eldar6776/Automatic-Lubrication/README.md

# Automatic-Lubrication
Machine Automatic Lubrication Cycle Counter
