eldar6776/Automatic-Lubrication/(list of files, cad)

Other CAD files:
fw/PIC12C508.X/dist/default/production/startup.obj
fw/PIC12C508.X/l.obj
fw/PIC12F675.X/dist/default/production/PIC12F675.X.production.obj
fw/PIC12F675.X/l.obj
fw/PIC12C508.X/dist/default/production/PIC12C508.X.production.obj
fw/PIC12F675.X/dist/default/production/startup.obj
