eldar6776/Automatic-Lubrication/Elektro schematic.pdf

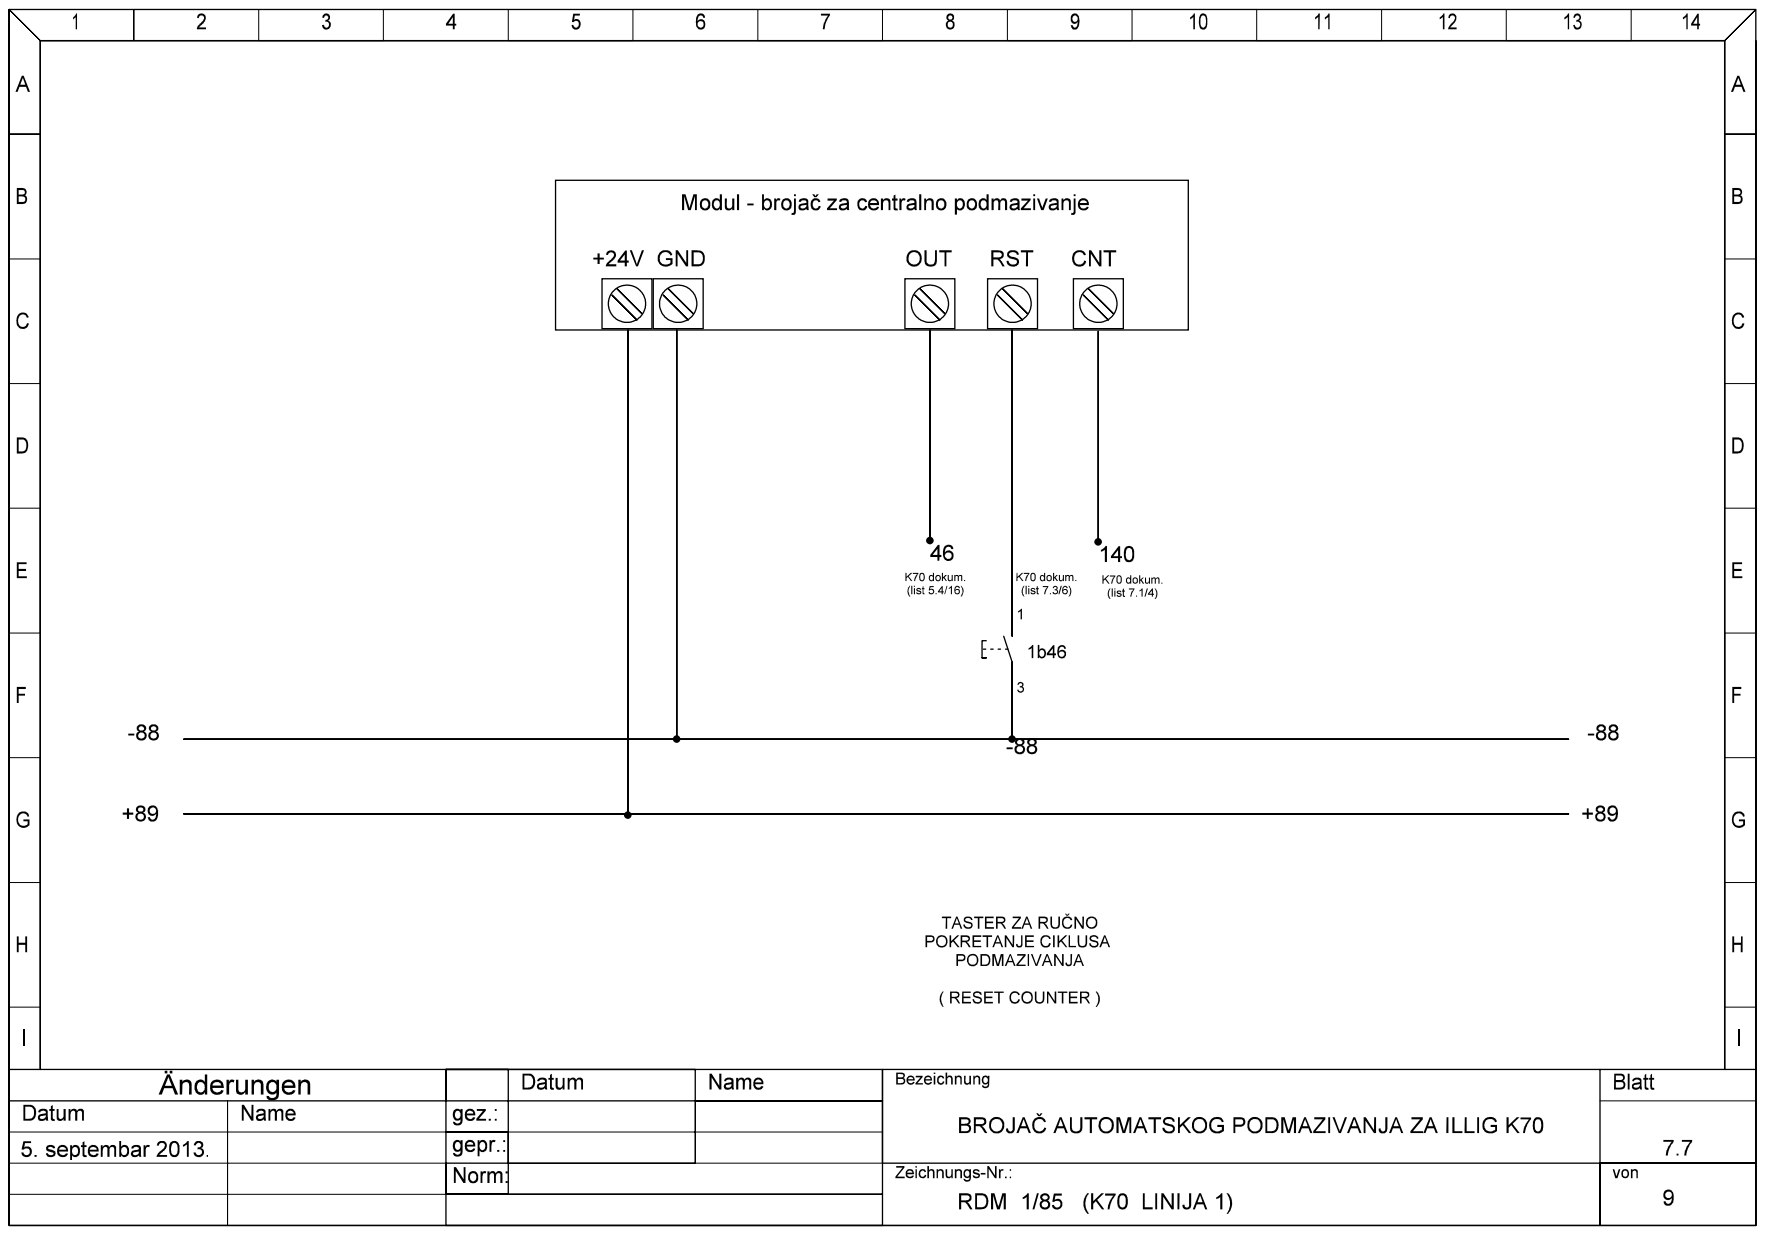
[picture p3: page 1]

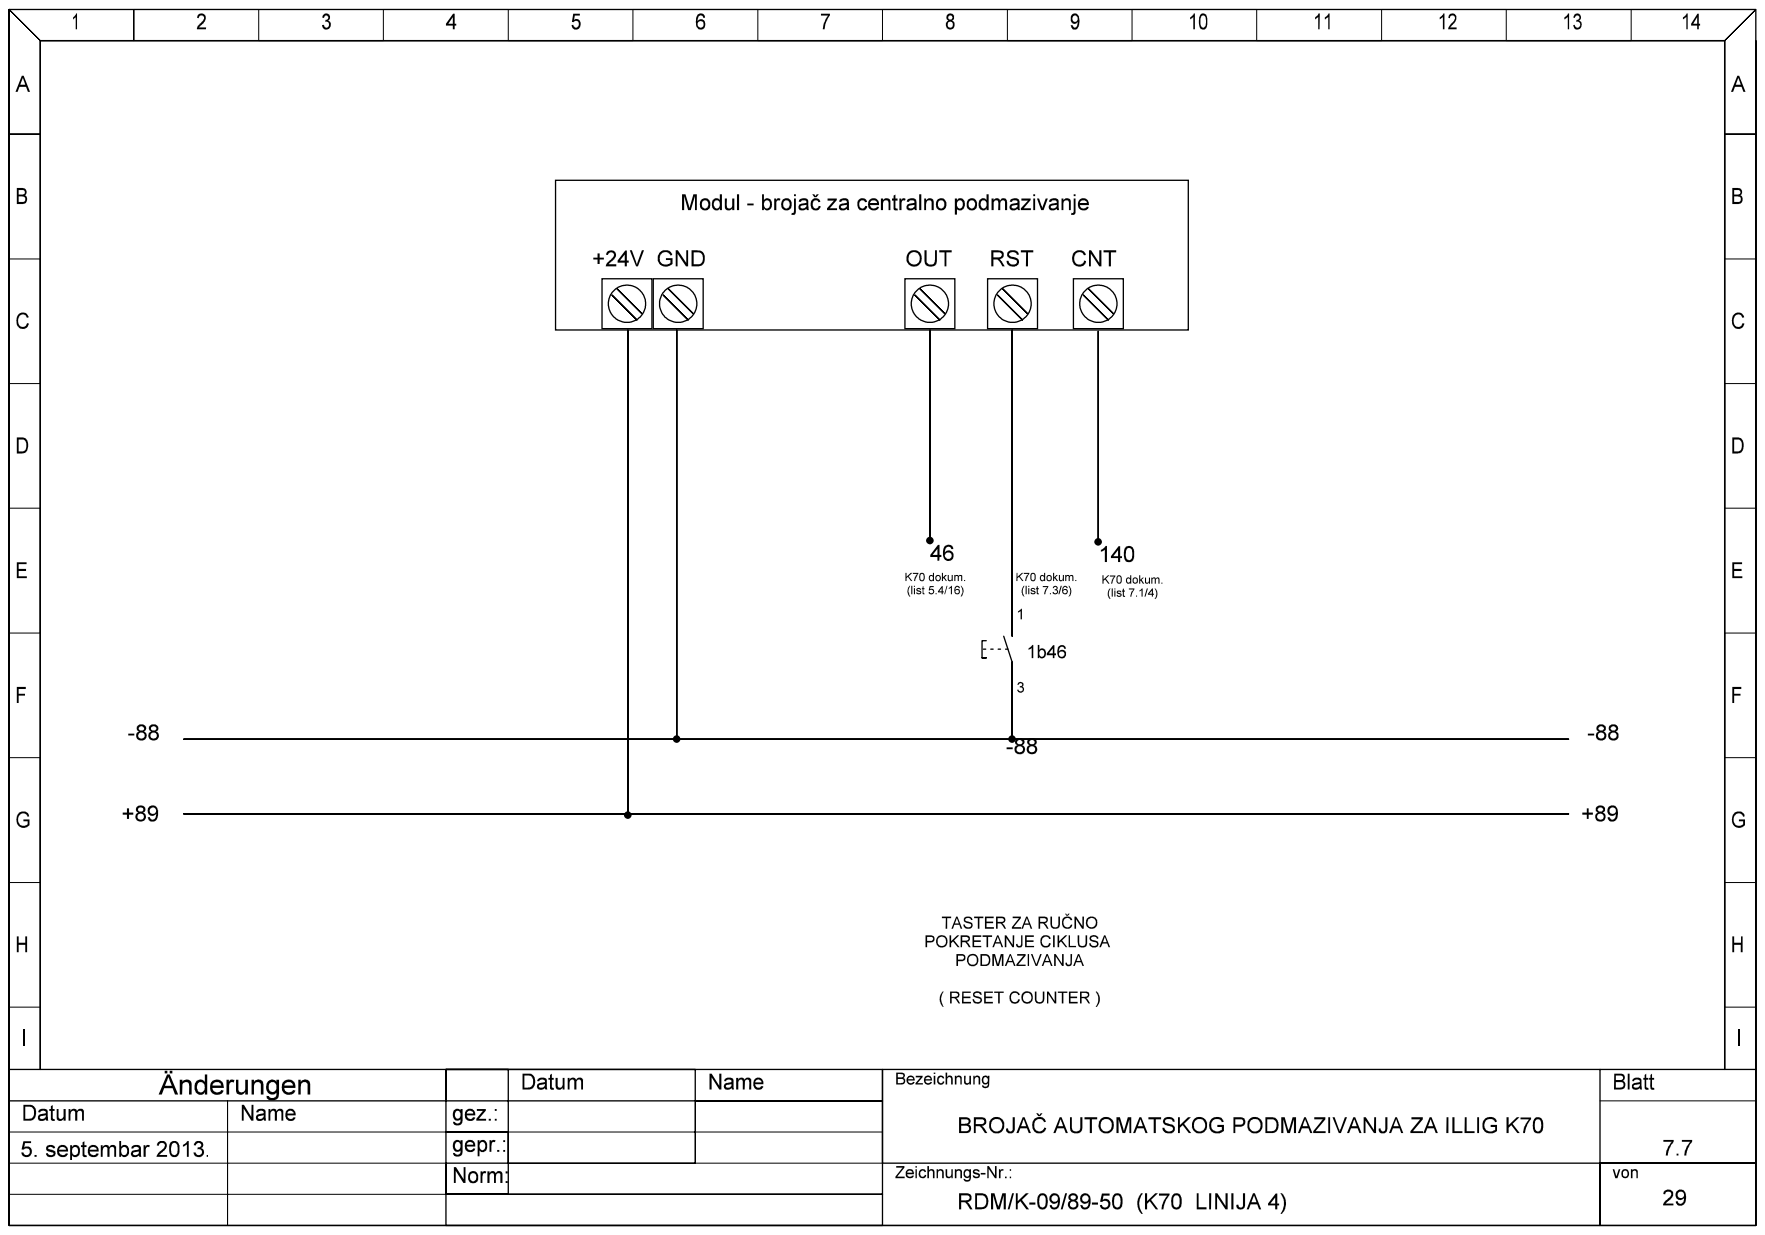
[picture p4: page 2]
