eldar6776/Automatic-Lubrication/(list of files, drawings)

Other design files:
hw/AUTOMATSKO_PODMAZIVANJE.PcbDoc
hw/AUTOMATSKO_PODMAZIVANJE.PrjPcb
hw/AUTOMATSKO_PODMAZIVANJE.SchDoc
hw/AUTOMATSKO_PODMAZIVANJE_copy.SchDoc
hw/TERMINAL_CONNECOR_2.PcbLib
hw/TERMINAL_CONNECOR_2.SchLib
hw/TERMINAL_CONNECOR_3.PcbLib
hw/TERMINAL_CONNECOR_3.SchLib
